leesanghun-droid/ulsan_nozzle_controller/AnyConv.com__PCB_부품배치.dxf

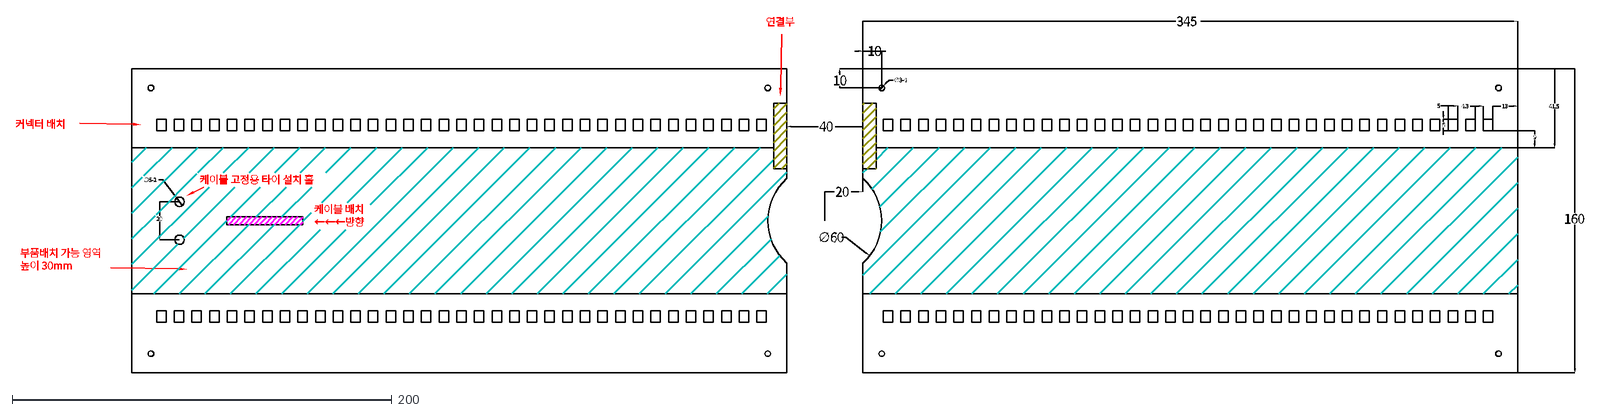
[picture p1: CAD file, 2023-03-30]
AnyConv.com__PCB_부품배치.dxf
345
160
10
∅60
20
40
부품배치 가능 영역
높이 30mm
케이블 배치
←←←방향
커넥터 배치
∅5-2
케이블 고정용 타이 설치 홀
∅3-4
9
13
4.3
5
6
41.5
연결부
