leesanghun-droid/ulsan_nozzle_controller/도면파일/PCB_부품배치_R12.dxf

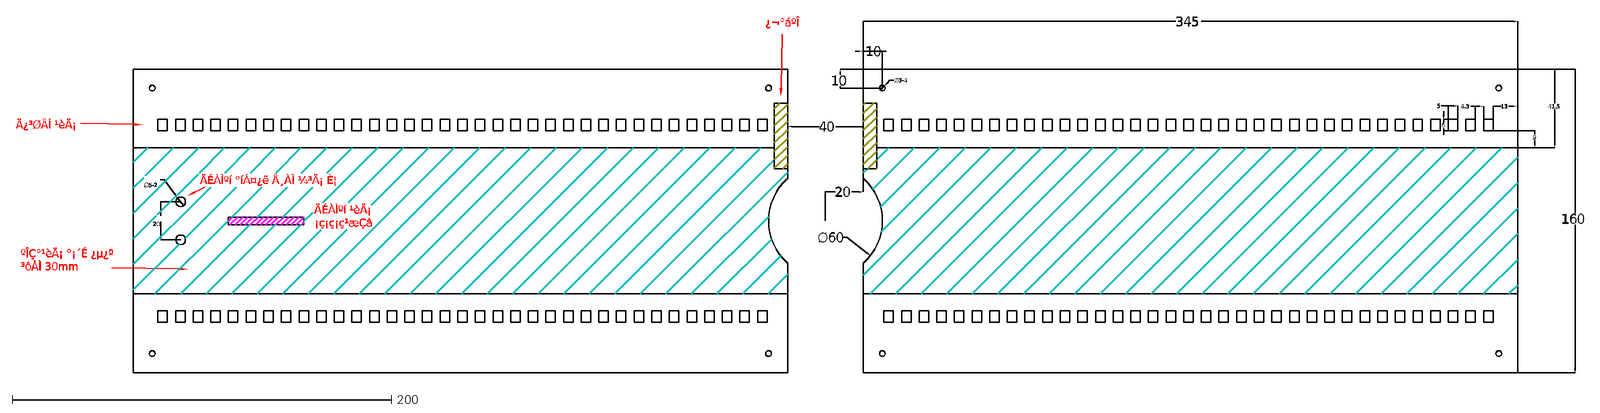
[picture p6: CAD file, 2023-03-30]
도면파일/PCB_부품배치_R12.dxf
345
160
10
∅60
20
40
ºÎÇ°¹èÄ¡ °¡´É ¿µ¿ª
³ôÀÌ 30mm
ÄÉÀÌºí ¹èÄ¡
¡ç¡ç¡ç¹æÇâ
Ä¿³ØÅÍ ¹èÄ¡
Ø5-2
ÄÉÀÌºí °íÁ¤¿ë Å¸ÀÌ ¼³Ä¡ È¦
∅3-4
9
13
4.3
5
6
41.5
¿¬°áºÎ
