leesanghun-droid/ulsan_nozzle_controller/도면파일/PCB_부품배치_1LAYER_2010.dxf

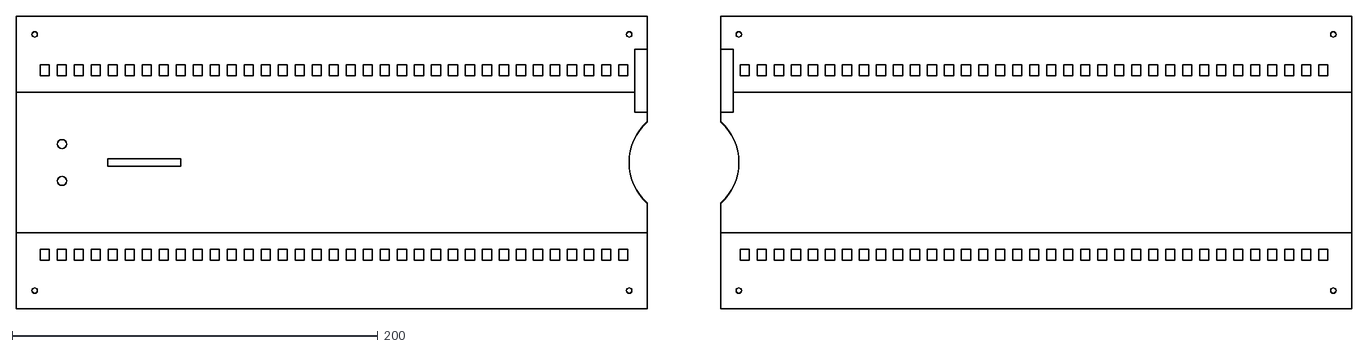
[picture p7: CAD file, 2023-03-30]
도면파일/PCB_부품배치_1LAYER_2010.dxf
730.0 x 160.0
