leesanghun-droid/ulsan_nozzle_controller/(list of files, cad)

Other CAD files:
PCB_부품배치.dwg
도면파일/PCB_부품배치_2007.dxf
도면파일/PCB_부품배치_2013.dxf
도면파일/PCB_부품배치_1LAYER.dwg
