leesanghun-droid/ulsan_nozzle_controller/NozzleControlBoard.kicad_pcb

## KiCad design NozzleControlBoard.kicad_pcb (2023-03-31)

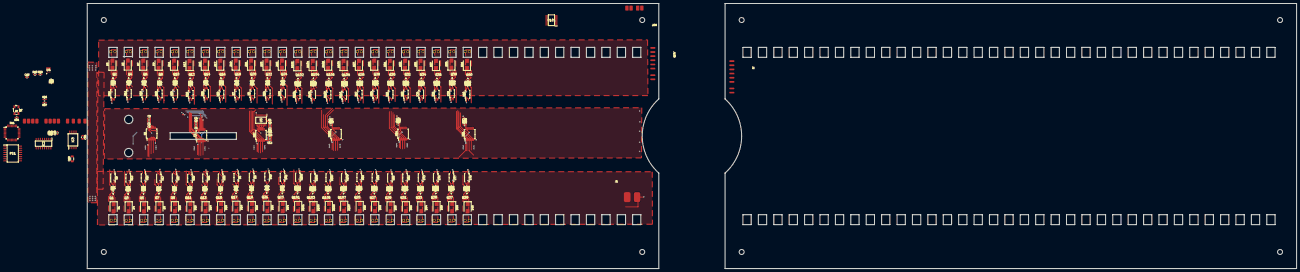
[picture p8: board NozzleControlBoard.kicad_pcb from above]

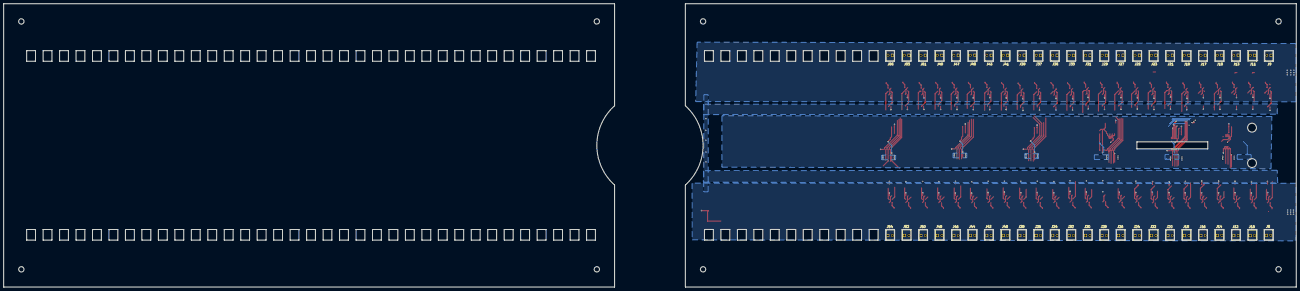
[picture p9: board NozzleControlBoard.kicad_pcb from below]

Board: 4 copper layers, 345.0 x 160.0 mm, 391 parts (48 on the bottom side), 276 nets.

Parts:
C1, C4, C7, C10, C16, C21, C24, C65: 0.1uF; C_0603_1608Metric
C2, C5, C8, C11, C17, C22, C25, C41, C66: 1uF; C_0603_1608Metric
C3, C6, C9, C12, C19, C23, C26, C51, C67: 10uF; C_0603_1608Metric
C18: 100uF; C_1206_3216Metric
C20, C46: NC; C_0603_1608Metric
C55: NC; C_0805_2012Metric
C63, C64: 10pF; C_0603_1608Metric
D1, D3, D4, D5, D6, D7, D8, D9, D10, D11, D12, D13, D14, D15, D16, D17, D18, D19, D20, D21, D22, D23, D24, D25, D26, D27, D28, D29, D30, D31, D32, D33, D34, D35, D36, D37, D38, D39, D40, D41, D101, D102, D103, D104, D105, D106, D107, D108: DIODE; D_SMB
IC2: MAX3094EESE+; SOIC127P600X175-16N
IC3: MAX22245BAWA+; SOIC127P1031X265-8N
J1: 24V_OUT; 24V_PAD
J2, J103: SHIFT_DATA_TOSS
J3: Conn_01x12_Male; input_pad
J8: SOL1; 2PIN
J9: SOL2; 2PIN
J10: SOL3; 2PIN
J11: SOL4; 2PIN
J12: SOL5; 2PIN
J13: SOL6; 2PIN
J14: SOL7; 2PIN
J15: SOL8; 2PIN
J16: SOL9; 2PIN
J17: SOL10; 2PIN
J18: SOL11; 2PIN
J19: SOL12; 2PIN
J20: SOL13; 2PIN
J21: SOL14; 2PIN
J22: SOL15; 2PIN
J23: SOL16; 2PIN
J24: SOL17; 2PIN
J25: SOL18; 2PIN
J26: SOL19; 2PIN
J27: SOL20; 2PIN
J28: SOL21; 2PIN
J29: SOL22; 2PIN
J30: SOL23; 2PIN
J31: SOL24; 2PIN
J32: SOL25; 2PIN
J33: SOL26; 2PIN
J34: SOL27; 2PIN
J35: SOL28; 2PIN
J36: SOL29; 2PIN
J37: SOL30; 2PIN
J38: SOL31; 2PIN
J39: SOL32; 2PIN
J40: SOL33; 2PIN
J41: SOL34; 2PIN
J42: SOL35; 2PIN
J43: SOL36; 2PIN
J44: SOL37; 2PIN
J45: SOL38; 2PIN
J46: SOL39; 2PIN
J47: SOL40; 2PIN
J48: SOL41; 2PIN
J49: SOL42; 2PIN
J50: SOL43; 2PIN
J51: SOL44; 2PIN
J52: SOL45; 2PIN
J53: SOL46; 2PIN
J54: SOL47; 2PIN
J55: SOL48; 2PIN
PS1: R05CTE05S-R; SOIC127P1030X265-16N
Q1, Q2, Q3, Q4, Q5, Q6, Q7, Q8, Q9, Q10, Q11, Q12, Q13, Q14, Q15, Q16, Q17, Q18, Q19, Q20, Q21, Q22, Q23, Q24, Q25, Q26, Q27, Q28, Q29, Q30, Q31, Q32, Q33, Q34, Q35, Q36, Q37, Q38, Q39, Q40, Q101, Q102, Q103, Q104, Q105, Q106, Q107, Q108: TPN22006NH,LQ; TPN22006NHLQ
R1: 100Ω; R_0603_1608Metric
R2, R3, R4, R5, R6, R7, R8, R9, R21, R22, R23, R24, R26, R27, R28, R29, R54, R56, R57, R58, R59, R61, R62, R63, R106, R107, R108, R109, R110, R111, R112, R113, R138, R139, R140, R141, R142, R143, R144, R145, R170, R171, R172, R173, R174, R175, R176, R177: 3.3kΩ; R_0603_1608Metric
R10, R11, R12, R13, R14, R15, R16, R17, R18, R19, R20, R25, R30, R31, R32, R33, R34, R35, R36, R37, R38, R39, R40, R41, R42, R43, R47, R48, R49, R50, R51, R64, R65, R66, R67, R68, R69, R70, R71, R72, R73, R74, R75, R76, R77, R78, R79, R96, R114, R115, R116, R117, R118, R119, R120, R121, R122, R123, R124, R125, R126, R127, R128, R129, R146, R147, R148, R149, R150, R151, R152, R153, R154, R155, R156, R157, R158, R159, R160, R161, R178, R179, R180, R181, R182, R183, R184, R185, R186, R187, R188, R189, R190, R191, R192, R193: 22kΩ; R_0603_1608Metric
R52: 5kΩ; R_0603_1608Metric
R55: 2kΩ; R_0603_1608Metric
R60: NC; R_0603_1608Metric
U1, U2, U47, U64, U81, U102: 74HCT595; SSOP-16_5.3x6.2mm_P0.65mm
U3, U6, U7, U8, U9, U12, U13, U14, U15, U16, U17, U18, U27, U28, U29, U30, U31, U32, U33, U34, U43, U44, U45, U46, U56, U57, U58, U59, U60, U61, U62, U63, U73, U74, U75, U76, U77, U78, U79, U80, U103, U104, U105, U106, U107, U108, U109, U110: TLP291; SOIC-4_4.55x2.6mm_P1.27mm
U4: ISP; TPN22006NHLQ
U5, U101: 74HC244; SOP65P640X110-20N
U11: ATmega8A-A; TQFP-32_7x7mm_P0.8mm
U87: SOL14; sol_pad
Y1: Crystal_GND24; Crystal_SMD_Abracon_ABM3B-4Pin_5.0x3.2mm

Connections:
/3.3V_3: IC2.4 (ENAC), IC2.12 (ENBD), IC2.16 (VCC), IC3.1 (VDDA)
/5V_3: C18.2, C20.2, C41.2, C46.2, C51.1, C55.1, J2.8, J3.1, J103.8, PS1.3 (+VIN_1), PS1.4 (+VIN_2)
/5V_4: C1.2, C2.2, C3.1, C4.2, C5.2, C6.1, C7.2, C8.2, C9.1, C10.2, C11.2, C12.1, C16.2, C17.2, C19.1, C21.2, C22.2, C23.1, C24.2, C25.2, C26.1, C65.2, C66.2, C67.1, IC3.8 (VDDB), J2.5, J103.5, PS1.13 (+VOUT_1), PS1.14 (+VOUT_2), R52.2, R55.1, R60.1, U1.10 (~SRCLR), U1.16 (VCC), U2.10 (~SRCLR), U2.16 (VCC), U3.1, U5.20 (VCC), U6.1, U7.1, U8.1, U9.1, U11.4 (VCC), U11.6 (VCC), U12.1, U13.1, U14.1, U15.1, U16.1, U17.1, U18.1, U27.1, U28.1, U29.1, U30.1, U31.1, U32.1, U33.1, U34.1, U43.1, U44.1, U45.1, U46.1, U47.10 (~SRCLR), U47.16 (VCC), U56.1, U57.1, U58.1, U59.1, U60.1, U61.1, U62.1, U63.1, U64.10 (~SRCLR), U64.16 (VCC), U73.1, U74.1, U75.1, U76.1, U77.1, U78.1, U79.1, U80.1, U81.10 (~SRCLR), U81.16 (VCC), U101.20 (VCC), U102.10 (~SRCLR), U102.16 (VCC), U103.1, U104.1, U105.1, U106.1, U107.1, U108.1, U109.1, U110.1
/24V2: J1.2, J3.9, J3.10, J3.11, J3.12, J8.1, J9.1, J10.1, J11.1, J12.1, J13.1, J14.1, J15.1, J16.1, J17.1, J18.1, J19.1, J20.1, J21.1, J22.1, J23.1, J24.1, J25.1, J26.1, J27.1, J28.1, J29.1, J30.1, J31.1, J32.1, J33.1, J34.1, J35.1, J36.1, J37.1, J38.1, J39.1, J40.1, J41.1, J42.1, J43.1, J44.1, J45.1, J46.1, J47.1, J48.1, J49.1, J50.1, J51.1, J52.1, J53.1, J54.1, J55.1, U3.4, U6.4, U7.4, U8.4, U9.4, U12.4, U13.4, U14.4, U15.4, U16.4, U17.4, U18.4, U27.4, U28.4, U29.4, U30.4, U31.4, U32.4, U33.4, U34.4, U43.4, U44.4, U45.4, U46.4, U56.4, U57.4, U58.4, U59.4, U60.4, U61.4, U62.4, U63.4, U73.4, U74.4, U75.4, U76.4, U77.4, U78.4, U79.4, U80.4, U87.1 (SOL+), U103.4, U104.4, U105.4, U106.4, U107.4, U108.4, U109.4, U110.4
/24V2_GND: D1.1 (K), D3.1 (K), D4.1 (K), D5.1 (K), D6.1 (K), D7.1 (K), D8.1 (K), D9.1 (K), D10.1 (K), D11.1 (K), D12.1 (K), D13.1 (K), D14.1 (K), D15.1 (K), D16.1 (K), D17.1 (K), D18.1 (K), D19.1 (K), D20.1 (K), D21.1 (K), D22.1 (K), D23.1 (K), D24.1 (K), D25.1 (K), D26.1 (K), D27.1 (K), D28.1 (K), D29.1 (K), D30.1 (K), D31.1 (K), D32.1 (K), D33.1 (K), D34.1 (K), D35.1 (K), D36.1 (K), D37.1 (K), D38.1 (K), D39.1 (K), D40.1 (K), D41.1 (K), D101.1 (K), D102.1 (K), D103.1 (K), D104.1 (K), D105.1 (K), D106.1 (K), D107.1 (K), D108.1 (K), J1.1, J3.5, J3.6, J3.7, J3.8, Q1.1 (S_1), Q1.2 (S_2), Q1.3 (S_3), Q2.1 (S_1), Q2.2 (S_2), Q2.3 (S_3), Q3.1 (S_1), Q3.2 (S_2), Q3.3 (S_3), Q4.1 (S_1), Q4.2 (S_2), Q4.3 (S_3), Q5.1 (S_1), Q5.2 (S_2), Q5.3 (S_3), Q6.1 (S_1), Q6.2 (S_2), Q6.3 (S_3), Q7.1 (S_1), Q7.2 (S_2), Q7.3 (S_3), Q8.1 (S_1), Q8.2 (S_2), Q8.3 (S_3), Q9.1 (S_1), Q9.2 (S_2), Q9.3 (S_3), Q10.1 (S_1), Q10.2 (S_2), Q10.3 (S_3), Q11.1 (S_1), Q11.2 (S_2), Q11.3 (S_3), Q12.1 (S_1), Q12.2 (S_2), Q12.3 (S_3), Q13.1 (S_1), Q13.2 (S_2), Q13.3 (S_3), Q14.1 (S_1), Q14.2 (S_2), Q14.3 (S_3), Q15.1 (S_1), Q15.2 (S_2), Q15.3 (S_3), Q16.1 (S_1), Q16.2 (S_2), Q16.3 (S_3), Q17.1 (S_1), Q17.2 (S_2), Q17.3 (S_3), Q18.1 (S_1), Q18.2 (S_2), Q18.3 (S_3), Q19.1 (S_1), Q19.2 (S_2), Q19.3 (S_3), Q20.1 (S_1), Q20.2 (S_2), Q20.3 (S_3), Q21.1 (S_1), Q21.2 (S_2), Q21.3 (S_3), Q22.1 (S_1), Q22.2 (S_2), Q22.3 (S_3), Q23.1 (S_1), Q23.2 (S_2), Q23.3 (S_3), Q24.1 (S_1), Q24.2 (S_2), Q24.3 (S_3), Q25.1 (S_1), Q25.2 (S_2), Q25.3 (S_3), Q26.1 (S_1), Q26.2 (S_2), Q26.3 (S_3), Q27.1 (S_1), Q27.2 (S_2), Q27.3 (S_3), Q28.1 (S_1), Q28.2 (S_2), Q28.3 (S_3), Q29.1 (S_1), Q29.2 (S_2), Q29.3 (S_3), Q30.1 (S_1), Q30.2 (S_2), Q30.3 (S_3), Q31.1 (S_1), Q31.2 (S_2), Q31.3 (S_3), Q32.1 (S_1), Q32.2 (S_2), Q32.3 (S_3), Q33.1 (S_1), Q33.2 (S_2), Q33.3 (S_3), Q34.1 (S_1), Q34.2 (S_2), Q34.3 (S_3), Q35.1 (S_1), Q35.2 (S_2), Q35.3 (S_3), Q36.1 (S_1), Q36.2 (S_2), Q36.3 (S_3), Q37.1 (S_1), Q37.2 (S_2), Q37.3 (S_3), Q38.1 (S_1), Q38.2 (S_2), Q38.3 (S_3), Q39.1 (S_1), Q39.2 (S_2), Q39.3 (S_3), Q40.1 (S_1), Q40.2 (S_2), Q40.3 (S_3), Q101.1 (S_1), Q101.2 (S_2), Q101.3 (S_3), Q102.1 (S_1), Q102.2 (S_2), Q102.3 (S_3), Q103.1 (S_1), Q103.2 (S_2), Q103.3 (S_3), Q104.1 (S_1), Q104.2 (S_2), Q104.3 (S_3), Q105.1 (S_1), Q105.2 (S_2), Q105.3 (S_3), Q106.1 (S_1), Q106.2 (S_2), Q106.3 (S_3), Q107.1 (S_1), Q107.2 (S_2), Q107.3 (S_3), Q108.1 (S_1), Q108.2 (S_2), Q108.3 (S_3), R11.2, R13.2, R15.2, R17.2, R19.2, R25.2, R31.2, R34.2, R36.2, R38.2, R40.2, R43.2, R47.2, R49.2, R51.2, R65.2, R67.2, R69.2, R71.2, R73.2, R75.2, R77.2, R79.2, R96.2, R115.2, R117.2, R119.2, R121.2, R123.2, R125.2, R127.2, R129.2, R147.2, R149.2, R151.2, R153.2, R155.2, R157.2, R159.2, R161.2, R179.2, R181.2, R183.2, R185.2, R187.2, R189.2, R191.2, R193.2
/CLK: J2.4, U1.11 (SRCLK), U2.11 (SRCLK), U11.26 (PC3)
/CLK_2: U5.18 (1Y0), U47.11 (SRCLK)
/CLK_3: J103.4, U64.11 (SRCLK), U81.11 (SRCLK), U101.18 (1Y0), U102.11 (SRCLK)
/DATA1_OUT: U1.9 (QH'), U2.14 (SER)
/DATA2_OUT: J2.1, U2.9 (QH')
/DATA3: IC2.3 (YA), IC3.2 (IN1)
/DATA3+: IC2.2 (A+), J3.3
/DATA3-: IC2.1 (A-), J3.2
/DATA3_INPUT: U5.12 (1Y3), U47.14 (SER)
/DATA4: IC3.7 (OUT1), R60.2, U11.30 (PD0)
/DATA4_INPUT: U101.12 (1Y3), U102.14 (SER)
/DATA4_OUT: U64.14 (SER), U102.9 (QH')
/DATA5_OUT: U64.9 (QH'), U81.14 (SER)
/DATA6_OUT: J103.1, U81.9 (QH')
/DATA_IN: U1.14 (SER), U11.23 (PC0)
/ENABLE: J2.2, R55.2, U1.13 (~OE), U2.13 (~OE), U11.24 (PC1)
/ENABLE_2: U5.14 (1Y2), U47.13 (~OE)
/ENABLE_3: J103.2, U64.13 (~OE), U81.13 (~OE), U101.14 (1Y2), U102.13 (~OE)
/GND_3: C18.1, C20.1, C41.1, C46.1, C51.2, C55.2, IC2.8 (GND), IC3.4 (GNDA), J2.7, J3.4, J103.7, PS1.1 (-VIN_1), PS1.2 (-VIN_2), PS1.5 (SGNDIN_1), PS1.6 (SGNDIN_2), PS1.7 (SGNDIN_3), PS1.8 (SGNDIN_4)
/GND_4: C1.1, C2.1, C3.2, C4.1, C5.1, C6.2, C7.1, C8.1, C9.2, C10.1, C11.1, C12.2, C16.1, C17.1, C19.2, C21.1, C22.1, C23.2, C24.1, C25.1, C26.2, C63.2, C64.2, C65.1, C66.1, C67.2, IC3.5 (GNDB), J2.6, J103.6, PS1.9 (SGNDOUT_1), PS1.11 (SGNDOUT_2), PS1.12 (SGNDOUT_3), PS1.15 (-VOUT_1), PS1.16 (-VOUT_2), R1.1, U1.8 (GND), U2.8 (GND), U5.10 (GND), U11.3 (GND), U11.5 (GND), U11.32 (PD2), U47.8 (GND), U64.8 (GND), U81.8 (GND), U101.10 (GND), U102.8 (GND), Y1.2, Y1.4
/LATCH: J2.3, U1.12 (RCLK), U2.12 (RCLK), U11.25 (PC2)
/LATCH_2: U5.16 (1Y1), U47.12 (RCLK)
/LATCH_3: J103.3, U64.12 (RCLK), U81.12 (RCLK), U101.16 (1Y1), U102.12 (RCLK)
/MISO: U4.3 (MISO), U11.16 (PB4)
/MOSI: U4.4 (MOSI), U11.15 (PB3)
/RESET: R52.1, U4.2 (RESET), U11.29 (PC6/~RESET)
/S1: R27.2, U1.15 (QA)
/S2: R21.2, U1.1 (QB)
/S3: R22.2, U1.2 (QC)
/S4: R23.2, U1.3 (QD)
/S5: R24.2, U1.4 (QE)
/S6: R26.2, U1.5 (QF)
/S7: R28.2, U1.6 (QG)
/S8: R29.2, U1.7 (QH)
/S9: R54.2, U2.15 (QA)
/S10: R56.2, U2.1 (QB)
/S11: R57.2, U2.2 (QC)
/S12: R58.2, U2.3 (QD)
/S13: R59.2, U2.4 (QE)
/S14: R61.2, U2.5 (QF)
/S15: R62.2, U2.6 (QG)
/S16: R63.2, U2.7 (QH)
/S17: R2.2, U47.15 (QA)
/S18: R3.2, U47.1 (QB)
/S19: R4.2, U47.2 (QC)
/S20: R5.2, U47.3 (QD)
/S21: R6.2, U47.4 (QE)
/S22: R7.2, U47.5 (QF)
/S23: R8.2, U47.6 (QG)
/S24: R9.2, U47.7 (QH)
/S25: R106.2, U102.15 (QA)
/S26: R107.2, U102.1 (QB)
/S27: R108.2, U102.2 (QC)
/S28: R109.2, U102.3 (QD)
/S29: R110.2, U102.4 (QE)
/S30: R111.2, U102.5 (QF)
/S31: R112.2, U102.6 (QG)
/S32: R113.2, U102.7 (QH)
/S33: R138.2, U64.15 (QA)
/S34: R139.2, U64.1 (QB)
/S35: R140.2, U64.2 (QC)
/S36: R141.2, U64.3 (QD)
/S37: R142.2, U64.4 (QE)
/S38: R143.2, U64.5 (QF)
/S39: R144.2, U64.6 (QG)
/S40: R145.2, U64.7 (QH)
/S41: R170.2, U81.15 (QA)
/S42: R171.2, U81.1 (QB)
/S43: R172.2, U81.2 (QC)
/S44: R173.2, U81.3 (QD)
/S45: R174.2, U81.4 (QE)
/S46: R175.2, U81.5 (QF)
/S47: R176.2, U81.6 (QG)
/S48: R177.2, U81.7 (QH)
/SCK: U4.1 (SCK), U11.17 (PB5)
/SOL1-: D1.2 (A), J8.2, Q1.5 (D_1), Q1.6 (D_2), Q1.7 (D_3), Q1.8 (D_4), Q1.9 (D_5)
/SOL2-: D3.2 (A), J9.2, Q2.5 (D_1), Q2.6 (D_2), Q2.7 (D_3), Q2.8 (D_4), Q2.9 (D_5)
/SOL3-: D4.2 (A), J10.2, Q3.5 (D_1), Q3.6 (D_2), Q3.7 (D_3), Q3.8 (D_4), Q3.9 (D_5)
/SOL4-: D5.2 (A), J11.2, Q4.5 (D_1), Q4.6 (D_2), Q4.7 (D_3), Q4.8 (D_4), Q4.9 (D_5)
/SOL5-: D6.2 (A), J12.2, Q5.5 (D_1), Q5.6 (D_2), Q5.7 (D_3), Q5.8 (D_4), Q5.9 (D_5)
/SOL6-: D7.2 (A), J13.2, Q6.5 (D_1), Q6.6 (D_2), Q6.7 (D_3), Q6.8 (D_4), Q6.9 (D_5)
/SOL7-: D8.2 (A), J14.2, Q7.5 (D_1), Q7.6 (D_2), Q7.7 (D_3), Q7.8 (D_4), Q7.9 (D_5)
/SOL8-: D9.2 (A), J15.2, Q8.5 (D_1), Q8.6 (D_2), Q8.7 (D_3), Q8.8 (D_4), Q8.9 (D_5)
/SOL9-: D10.2 (A), J16.2, Q9.5 (D_1), Q9.6 (D_2), Q9.7 (D_3), Q9.8 (D_4), Q9.9 (D_5)
/SOL10-: D11.2 (A), J17.2, Q10.5 (D_1), Q10.6 (D_2), Q10.7 (D_3), Q10.8 (D_4), Q10.9 (D_5)
/SOL11-: D12.2 (A), J18.2, Q11.5 (D_1), Q11.6 (D_2), Q11.7 (D_3), Q11.8 (D_4), Q11.9 (D_5)
/SOL12-: D13.2 (A), J19.2, Q12.5 (D_1), Q12.6 (D_2), Q12.7 (D_3), Q12.8 (D_4), Q12.9 (D_5)
/SOL13-: D14.2 (A), J20.2, Q13.5 (D_1), Q13.6 (D_2), Q13.7 (D_3), Q13.8 (D_4), Q13.9 (D_5)
/SOL14-: D15.2 (A), J21.2, Q14.5 (D_1), Q14.6 (D_2), Q14.7 (D_3), Q14.8 (D_4), Q14.9 (D_5)
/SOL15-: D16.2 (A), J22.2, Q15.5 (D_1), Q15.6 (D_2), Q15.7 (D_3), Q15.8 (D_4), Q15.9 (D_5)
/SOL16-: D17.2 (A), J23.2, Q16.5 (D_1), Q16.6 (D_2), Q16.7 (D_3), Q16.8 (D_4), Q16.9 (D_5)
/SOL17-: D18.2 (A), J24.2, Q17.5 (D_1), Q17.6 (D_2), Q17.7 (D_3), Q17.8 (D_4), Q17.9 (D_5)
/SOL18-: D19.2 (A), J25.2, Q18.5 (D_1), Q18.6 (D_2), Q18.7 (D_3), Q18.8 (D_4), Q18.9 (D_5)
/SOL19-: D20.2 (A), J26.2, Q19.5 (D_1), Q19.6 (D_2), Q19.7 (D_3), Q19.8 (D_4), Q19.9 (D_5)
/SOL20-: D21.2 (A), J27.2, Q20.5 (D_1), Q20.6 (D_2), Q20.7 (D_3), Q20.8 (D_4), Q20.9 (D_5)
/SOL21-: D22.2 (A), J28.2, Q21.5 (D_1), Q21.6 (D_2), Q21.7 (D_3), Q21.8 (D_4), Q21.9 (D_5)
/SOL22-: D23.2 (A), J29.2, Q22.5 (D_1), Q22.6 (D_2), Q22.7 (D_3), Q22.8 (D_4), Q22.9 (D_5)
/SOL23-: D24.2 (A), J30.2, Q23.5 (D_1), Q23.6 (D_2), Q23.7 (D_3), Q23.8 (D_4), Q23.9 (D_5)
/SOL24-: D25.2 (A), J31.2, Q24.5 (D_1), Q24.6 (D_2), Q24.7 (D_3), Q24.8 (D_4), Q24.9 (D_5)
/SOL25-: D101.2 (A), J32.2, Q101.5 (D_1), Q101.6 (D_2), Q101.7 (D_3), Q101.8 (D_4), Q101.9 (D_5)
/SOL26-: D102.2 (A), J33.2, Q102.5 (D_1), Q102.6 (D_2), Q102.7 (D_3), Q102.8 (D_4), Q102.9 (D_5)
/SOL27-: D103.2 (A), J34.2, Q103.5 (D_1), Q103.6 (D_2), Q103.7 (D_3), Q103.8 (D_4), Q103.9 (D_5)
/SOL28-: D104.2 (A), J35.2, Q104.5 (D_1), Q104.6 (D_2), Q104.7 (D_3), Q104.8 (D_4), Q104.9 (D_5)
/SOL29-: D105.2 (A), J36.2, Q105.5 (D_1), Q105.6 (D_2), Q105.7 (D_3), Q105.8 (D_4), Q105.9 (D_5)
/SOL30-: D106.2 (A), J37.2, Q106.5 (D_1), Q106.6 (D_2), Q106.7 (D_3), Q106.8 (D_4), Q106.9 (D_5)
/SOL31-: D107.2 (A), J38.2, Q107.5 (D_1), Q107.6 (D_2), Q107.7 (D_3), Q107.8 (D_4), Q107.9 (D_5)
/SOL32-: D108.2 (A), J39.2, Q108.5 (D_1), Q108.6 (D_2), Q108.7 (D_3), Q108.8 (D_4), Q108.9 (D_5)
/SOL33-: D26.2 (A), J40.2, Q25.5 (D_1), Q25.6 (D_2), Q25.7 (D_3), Q25.8 (D_4), Q25.9 (D_5)
/SOL34-: D27.2 (A), J41.2, Q26.5 (D_1), Q26.6 (D_2), Q26.7 (D_3), Q26.8 (D_4), Q26.9 (D_5)
/SOL35-: D28.2 (A), J42.2, Q27.5 (D_1), Q27.6 (D_2), Q27.7 (D_3), Q27.8 (D_4), Q27.9 (D_5)
/SOL36-: D29.2 (A), J43.2, Q28.5 (D_1), Q28.6 (D_2), Q28.7 (D_3), Q28.8 (D_4), Q28.9 (D_5)
/SOL37-: D30.2 (A), J44.2, Q29.5 (D_1), Q29.6 (D_2), Q29.7 (D_3), Q29.8 (D_4), Q29.9 (D_5)
/SOL38-: D31.2 (A), J45.2, Q30.5 (D_1), Q30.6 (D_2), Q30.7 (D_3), Q30.8 (D_4), Q30.9 (D_5)
/SOL39-: D32.2 (A), J46.2, Q31.5 (D_1), Q31.6 (D_2), Q31.7 (D_3), Q31.8 (D_4), Q31.9 (D_5)
/SOL40-: D33.2 (A), J47.2, Q32.5 (D_1), Q32.6 (D_2), Q32.7 (D_3), Q32.8 (D_4), Q32.9 (D_5)
/SOL41-: D34.2 (A), J48.2, Q33.5 (D_1), Q33.6 (D_2), Q33.7 (D_3), Q33.8 (D_4), Q33.9 (D_5)
/SOL42-: D35.2 (A), J49.2, Q34.5 (D_1), Q34.6 (D_2), Q34.7 (D_3), Q34.8 (D_4), Q34.9 (D_5)
/SOL43-: D36.2 (A), J50.2, Q35.5 (D_1), Q35.6 (D_2), Q35.7 (D_3), Q35.8 (D_4), Q35.9 (D_5)
/SOL44-: D37.2 (A), J51.2, Q36.5 (D_1), Q36.6 (D_2), Q36.7 (D_3), Q36.8 (D_4), Q36.9 (D_5)
/SOL45-: D38.2 (A), J52.2, Q37.5 (D_1), Q37.6 (D_2), Q37.7 (D_3), Q37.8 (D_4), Q37.9 (D_5)
/SOL46-: D39.2 (A), J53.2, Q38.5 (D_1), Q38.6 (D_2), Q38.7 (D_3), Q38.8 (D_4), Q38.9 (D_5), U87.3 (SOL-), U87.4 (LED-)
/SOL47-: D40.2 (A), J54.2, Q39.5 (D_1), Q39.6 (D_2), Q39.7 (D_3), Q39.8 (D_4), Q39.9 (D_5)
/SOL48-: D41.2 (A), J55.2, Q40.5 (D_1), Q40.6 (D_2), Q40.7 (D_3), Q40.8 (D_4), Q40.9 (D_5)
/X_TAL1: C63.1, U11.7 (PB6/XTAL1), Y1.1
/X_TAL2: C64.1, U11.8 (PB7/XTAL2), Y1.3
unnamed: Q1.4 (G), R42.1, R43.1
unnamed: Q2.4 (G), R33.1, R34.1
unnamed: Q3.4 (G), R35.1, R36.1
unnamed: Q4.4 (G), R37.1, R38.1
unnamed: Q5.4 (G), R39.1, R40.1
unnamed: Q6.4 (G), R41.1, R47.1
unnamed: Q7.4 (G), R48.1, R49.1
unnamed: Q8.4 (G), R50.1, R51.1
unnamed: Q9.4 (G), R64.1, R65.1
unnamed: Q10.4 (G), R66.1, R67.1
unnamed: Q11.4 (G), R68.1, R69.1
unnamed: Q12.4 (G), R70.1, R71.1
unnamed: Q13.4 (G), R72.1, R73.1
unnamed: Q14.4 (G), R74.1, R75.1
unnamed: Q15.4 (G), R76.1, R77.1
unnamed: Q16.4 (G), R78.1, R79.1
unnamed: Q17.4 (G), R10.1, R11.1
unnamed: Q18.4 (G), R12.1, R13.1
unnamed: Q19.4 (G), R14.1, R15.1
unnamed: Q20.4 (G), R16.1, R17.1
unnamed: Q21.4 (G), R18.1, R19.1
unnamed: Q22.4 (G), R20.1, R25.1
unnamed: Q23.4 (G), R30.1, R31.1
unnamed: Q24.4 (G), R32.1, R96.1
unnamed: Q25.4 (G), R146.1, R147.1
unnamed: Q26.4 (G), R148.1, R149.1
unnamed: Q27.4 (G), R150.1, R151.1
unnamed: Q28.4 (G), R152.1, R153.1
unnamed: Q29.4 (G), R154.1, R155.1
unnamed: Q30.4 (G), R156.1, R157.1
unnamed: Q31.4 (G), R158.1, R159.1
unnamed: Q32.4 (G), R160.1, R161.1
unnamed: Q33.4 (G), R178.1, R179.1
unnamed: Q34.4 (G), R180.1, R181.1
unnamed: Q35.4 (G), R182.1, R183.1
unnamed: Q36.4 (G), R184.1, R185.1
unnamed: Q37.4 (G), R186.1, R187.1
unnamed: Q38.4 (G), R188.1, R189.1
unnamed: Q39.4 (G), R190.1, R191.1
unnamed: Q40.4 (G), R192.1, R193.1
unnamed: Q101.4 (G), R114.1, R115.1
unnamed: Q102.4 (G), R116.1, R117.1
unnamed: Q103.4 (G), R118.1, R119.1
unnamed: Q104.4 (G), R120.1, R121.1
unnamed: Q105.4 (G), R122.1, R123.1
unnamed: Q106.4 (G), R124.1, R125.1
unnamed: Q107.4 (G), R126.1, R127.1
unnamed: Q108.4 (G), R128.1, R129.1
unnamed: R2.1, U6.2
unnamed: R3.1, U7.2
unnamed: R4.1, U8.2
unnamed: R5.1, U9.2
unnamed: R6.1, U43.2
unnamed: R7.1, U44.2
unnamed: R8.1, U45.2
unnamed: R9.1, U46.2
unnamed: R10.2, U6.3
unnamed: R12.2, U7.3
unnamed: R14.2, U8.3
unnamed: R16.2, U9.3
unnamed: R18.2, U43.3
unnamed: R20.2, U44.3
unnamed: R21.1, U12.2
unnamed: R22.1, U13.2
unnamed: R23.1, U14.2
unnamed: R24.1, U15.2
unnamed: R26.1, U16.2
unnamed: R27.1, U3.2
unnamed: R28.1, U17.2
unnamed: R29.1, U18.2
unnamed: R30.2, U45.3
unnamed: R32.2, U46.3
unnamed: R33.2, U12.3
unnamed: R35.2, U13.3
unnamed: R37.2, U14.3
unnamed: R39.2, U15.3
unnamed: R41.2, U16.3
unnamed: R42.2, U3.3
unnamed: R48.2, U17.3
unnamed: R50.2, U18.3
unnamed: R54.1, U27.2
unnamed: R56.1, U28.2
unnamed: R57.1, U29.2
unnamed: R58.1, U30.2
unnamed: R59.1, U31.2
unnamed: R61.1, U32.2
unnamed: R62.1, U33.2
unnamed: R63.1, U34.2
unnamed: R64.2, U27.3
unnamed: R66.2, U28.3
unnamed: R68.2, U29.3
unnamed: R70.2, U30.3
unnamed: R72.2, U31.3
unnamed: R74.2, U32.3
unnamed: R76.2, U33.3
unnamed: R78.2, U34.3
unnamed: R106.1, U103.2
unnamed: R107.1, U104.2
unnamed: R108.1, U105.2
unnamed: R109.1, U106.2
unnamed: R110.1, U107.2
unnamed: R111.1, U108.2
unnamed: R112.1, U109.2
unnamed: R113.1, U110.2
unnamed: R114.2, U103.3
unnamed: R116.2, U104.3
unnamed: R118.2, U105.3
unnamed: R120.2, U106.3
unnamed: R122.2, U107.3
unnamed: R124.2, U108.3
unnamed: R126.2, U109.3
unnamed: R128.2, U110.3
unnamed: R138.1, U56.2
unnamed: R139.1, U57.2
unnamed: R140.1, U58.2
unnamed: R141.1, U59.2
unnamed: R142.1, U60.2
unnamed: R143.1, U61.2
unnamed: R144.1, U62.2
unnamed: R145.1, U63.2
unnamed: R146.2, U56.3
unnamed: R148.2, U57.3
unnamed: R150.2, U58.3
unnamed: R152.2, U59.3
unnamed: R154.2, U60.3
unnamed: R156.2, U61.3
unnamed: R158.2, U62.3
unnamed: R160.2, U63.3
unnamed: R170.1, U73.2
unnamed: R171.1, U74.2
unnamed: R172.1, U75.2
unnamed: R173.1, U76.2
unnamed: R174.1, U77.2
unnamed: R175.1, U78.2
unnamed: R176.1, U79.2
unnamed: R177.1, U80.2
unnamed: R178.2, U73.3
unnamed: R180.2, U74.3
unnamed: R182.2, U75.3
unnamed: R184.2, U76.3
unnamed: R186.2, U77.3
unnamed: R188.2, U78.3
unnamed: R190.2, U79.3
unnamed: R192.2, U80.3
unnamed: R1.2, U5.1 (1OE), U5.19 (2OE)
unnamed: U101.1 (1OE), U101.19 (2OE)
