leesanghun-droid/ulsan_nozzle_controller/(commit log)

2023-03-10 .
    .
    [NozzleControlBoard.kicad_sch]
2023-03-29 ,
    ,
    [NozzleControlBoard.kicad_pcb, NozzleControlBoard.kicad_sch]
2023-03-31 이은혜
    텍스트를 추가함
2023-03-31 이은혜
    3/31
    [NozzleControlBoard.kicad_pcb, NozzleControlBoard.kicad_sch]
2023-04-01 이은혜
    4/1
    [NozzleControlBoard.kicad_sch]
2023-04-02 이은혜
    4/2
    [NozzleControlBoard.kicad_sch]
2023-04-04 이은혜
    4/3
2023-04-05 이은혜
    확인바람
2023-04-05 이은혜
    4/5
2023-04-06 이은혜
    4/7 32CH 확인해주세요
    [NozzleControlBoard.kicad_sch]
2023-04-07 이은혜
    ....
    [NozzleControlBoard.kicad_sch]
2023-04-07 이은혜
    4/7 이번주는 고만@!
2023-04-08 이은혜
    4/8
2023-04-09 이은혜
    4/9
2023-04-11 이은혜
    4/11
    [NozzleControlBoard.kicad_sch]
2023-04-12 이은혜
    4/12
2023-04-13 이은혜
    4/13
    [NozzleControlBoard.kicad_sch]
2023-04-14 이은혜
    4/14
2023-04-15 이은혜
    4/15
2023-04-17 이은혜
    4/17
2023-04-18 이은혜
    4/18
2023-04-18 이은혜
    오류수정
